GourdBrothers/8-Pads-WiFi-Fat-Scale/(list of files, drawings)

Other design files:
HardWare/SIC18102 V1 8电极6005_20180920.PcbDoc
