GourdBrothers/8-Pads-WiFi-Fat-Scale/S-F200VX_20180919/ISR_LED.asm

;==============================================================
;======= ISR_LED.ASM
;==============================================================
INTERRUPT_LED_ENTRY:
        INCF	R_LED_COUNT,F
		MOVLW	7
		SUBWF	R_LED_COUNT,W
		BTFSC	STATUS,C
		CLRF	R_LED_COUNT

		MOVLW	FFH              ; CLOSE ALL DISP
		MOVWF	PT2
		MOVWF	PT2CON
		MOVWF	LEDZCON
		MOVWF	R_LED_LIGHT
		
		CLRF	R_LED_DUTY
		
		MOVFW	R_LED_COUNT
		ADDPCW	
		GOTO	INTERRUPT_LED_P20
		GOTO	INTERRUPT_LED_P21
;		GOTO	INTERRUPT_LED_P22
		GOTO	INTERRUPT_LED_P23
		GOTO	INTERRUPT_LED_P24
		GOTO	INTERRUPT_LED_P25
		GOTO	INTERRUPT_LED_P26
		GOTO	INTERRUPT_LED_P27

INTERRUPT_LED_P20:		
    ; PT2.0
	    BTFSC   LED1,0         ; PT21
	    INCF	R_LED_DUTY,F 
	    BTFSC   LED1,6         ; PT23
	    INCF	R_LED_DUTY,F
	    BTFSC   LED2,2         ; PT24
	    INCF	R_LED_DUTY,F
	    BTFSC   LED4,6         ; PT25
	    INCF	R_LED_DUTY,F
	    BTFSC   LED2,3         ; PT26
	    INCF	R_LED_DUTY,F
	    BTFSC   LED7,0         ; PT27
	    INCF	R_LED_DUTY,F

	    BTFSC   LED1,0         ; PT21
	    BCF     R_LED_LIGHT,1
	    BTFSC   LED1,6         ; PT23
	    BCF     R_LED_LIGHT,3
	    BTFSC   LED2,2         ; PT24
	    BCF     R_LED_LIGHT,4
	    BTFSC   LED4,6         ; PT25
	    BCF     R_LED_LIGHT,5
	    BTFSC   LED2,3         ; PT26
	    BCF     R_LED_LIGHT,6
	    BTFSC   LED7,0         ; PT27
	    BCF     R_LED_LIGHT,7

		MOVLW 	11111111B
		XORWF	R_LED_LIGHT,W
		BTFSC	STATUS,Z
		GOTO	INTERRUPT_LED_END

        BCF     R_LED_LIGHT,0
		MOVFW	R_LED_LIGHT
		MOVWF	PT2CON        ; 
		MOVWF	LEDTEST2      ; IO - HZ
		
		MOVLW	11111010B
		MOVWF	PT2
		
		GOTO	INTERRUPT_LED_END
		
INTERRUPT_LED_P21:		
    ; PT2.1
	    BTFSC	LED2,0      ; PT20
	    INCF	R_LED_DUTY,F
	    BTFSC	LED1,1      ; PT23
	    INCF	R_LED_DUTY,F
	    BTFSC	LED3,7      ; PT24
	    INCF	R_LED_DUTY,F
	    BTFSC	LED3,1      ; PT25
	    INCF	R_LED_DUTY,F
	    BTFSC	LED7,7      ; PT26
	    INCF	R_LED_DUTY,F
	    BTFSC	LED7,1      ; PT27
	    INCF	R_LED_DUTY,F

	    BTFSC	LED2,0      ; PT20
	    BCF		R_LED_LIGHT,0
	    BTFSC	LED1,1      ; PT23
	    BCF		R_LED_LIGHT,3
	    BTFSC	LED3,7      ; PT24
	    BCF		R_LED_LIGHT,4
	    BTFSC	LED3,1      ; PT25
	    BCF		R_LED_LIGHT,5
	    BTFSC	LED7,7      ; PT26
	    BCF		R_LED_LIGHT,6
	    BTFSC	LED7,1      ; PT27
	    BCF		R_LED_LIGHT,7

		MOVLW	11111111B
		XORWF	R_LED_LIGHT,W
		BTFSC	STATUS,Z
		GOTO	INTERRUPT_LED_END
		
		BCF		R_LED_LIGHT,1
		MOVFW	R_LED_LIGHT
		MOVWF	PT2CON
		MOVWF	LEDTEST2      ; IO - HZ
				
		MOVLW	11111001B
		MOVWF	PT2
		
		GOTO	INTERRUPT_LED_END

INTERRUPT_LED_P23:		
		;PT2.3
		BTFSC	LED2,6        ; PT20
		INCF	R_LED_DUTY,F
		BTFSC	LED1,5        ; PT21
		INCF	R_LED_DUTY,F
		BTFSC	LED5,4        ; PT24
		INCF	R_LED_DUTY,F
		BTFSC	LED5,3        ; PT25
		INCF	R_LED_DUTY,F
		BTFSC	LED1,2        ; PT26
		INCF	R_LED_DUTY,F		
		BTFSC	LED7,3        ; PT27
		INCF	R_LED_DUTY,F

		BTFSC	LED2,6        ; PT20
		BCF		R_LED_LIGHT,0
		BTFSC	LED1,5        ; PT21
		BCF		R_LED_LIGHT,1
		BTFSC	LED5,4        ; PT24
		BCF		R_LED_LIGHT,4
		BTFSC	LED5,3        ; PT25
		BCF		R_LED_LIGHT,5
		BTFSC	LED1,2        ; PT26
		BCF		R_LED_LIGHT,6
        BTFSC	LED7,3        ; PT27
        BCF		R_LED_LIGHT,7
		
		MOVLW	11111111B
		XORWF	R_LED_LIGHT,W
		BTFSC	STATUS,Z
		GOTO	INTERRUPT_LED_END
		
		BCF		R_LED_LIGHT,3
		MOVFW	R_LED_LIGHT
		MOVWF	PT2CON
		MOVWF	LEDTEST2      ; IO - HZ		
		
		MOVLW	11110011B
		MOVWF	PT2
		
		GOTO	INTERRUPT_LED_END

INTERRUPT_LED_P24:		
		;PT2.4
		BTFSC	LED2,4        ; PT20
		INCF	R_LED_DUTY,F
		BTFSC	LED5,6        ; PT21
		INCF	R_LED_DUTY,F
		BTFSC	LED5,2        ; PT23
		INCF	R_LED_DUTY,F
		BTFSC	LED4,4        ; PT25
		INCF	R_LED_DUTY,F
		BTFSC	LED4,3        ; PT26
		INCF	R_LED_DUTY,F
		BTFSC	LED7,4        ; PT27
		INCF	R_LED_DUTY,F

		BTFSC	LED2,4        ; PT20
		BCF		R_LED_LIGHT,0
		BTFSC	LED5,6        ; PT21
		BCF		R_LED_LIGHT,1
		BTFSC	LED5,2        ; PT23
		BCF		R_LED_LIGHT,3
		BTFSC	LED4,4        ; PT25
		BCF		R_LED_LIGHT,5
		BTFSC	LED4,3        ; PT26
		BCF		R_LED_LIGHT,6
		BTFSC	LED7,4        ; PT27
		BCF		R_LED_LIGHT,7
		
		MOVLW	11111111B
		XORWF	R_LED_LIGHT,W
		BTFSC	STATUS,Z
		GOTO	INTERRUPT_LED_END
		
		BCF		R_LED_LIGHT,4
		MOVFW	R_LED_LIGHT
		MOVWF	PT2CON
		MOVWF	LEDTEST2      ; IO - HZ		
		
		MOVLW	11101011B
		MOVWF	PT2
		
		GOTO	INTERRUPT_LED_END

INTERRUPT_LED_P25:				
		;PT2.5
		BTFSC	LED3,6        ; PT20
		INCF	R_LED_DUTY,F
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
		GOTO	INTERRUPT_LED_END2
		MOVLW	110			         ;	    4
		GOTO	INTERRUPT_LED_END2
		MOVLW	110			         ;	    5
		GOTO	INTERRUPT_LED_END2
		MOVLW	180			         ;	    6
		GOTO	INTERRUPT_LED_END2
		MOVLW	250			         ;	    7
		GOTO	INTERRUPT_LED_END2
INTERRUPT_LED_END2:	
		MOVWF	TM1IN
		
		
