GourdBrothers/8-Pads-WiFi-Fat-Scale/(commit log)

2018-09-23 20180923-1403,创建文件
    [SIC18102 V1 8电极6005_20180920.PcbDoc]
2018-09-23 temp_产测部分代码编写中——20180924
2018-09-30 20180930产测中间件
2018-10-08 20181008,产测软件已初步编写完成，还差低电检测这一部分还没有编写代码
2018-10-09 1.加入上电标记读取判断，决定程序走向用户还是进入产测 2.优化了产测的内部，加入了低电量的检测
2018-10-10 1.产测模式程序自测OK 2.文档编写
